alvaroaranibar/controlled_rectifier/schematic.pdf

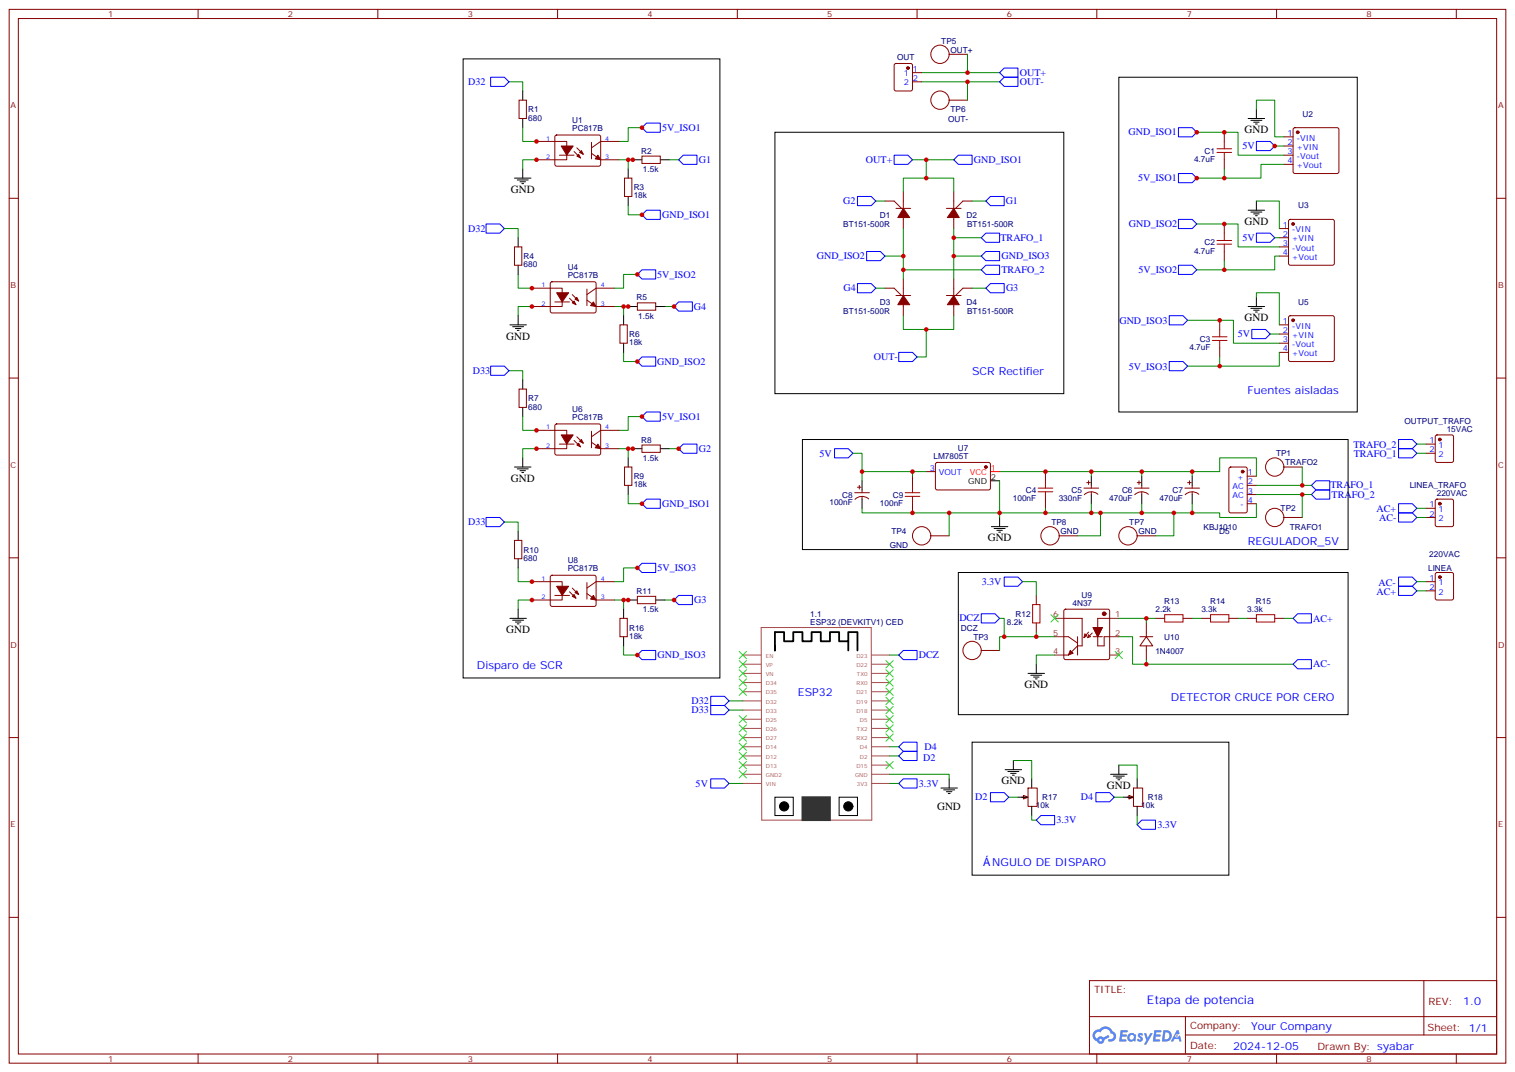
[picture p1: page 1]

DETECTOR CRUCE POR CERO
