alvaroaranibar/controlled_rectifier/(list of files, drawings)

Other design files:
PCB_altium.pcbdoc
PCB_EasyEDA.json
schematic_easyeda.json
